microtherion/AutoISP/AutoISP.brd

## EAGLE design AutoISP.brd (2015-08-15)

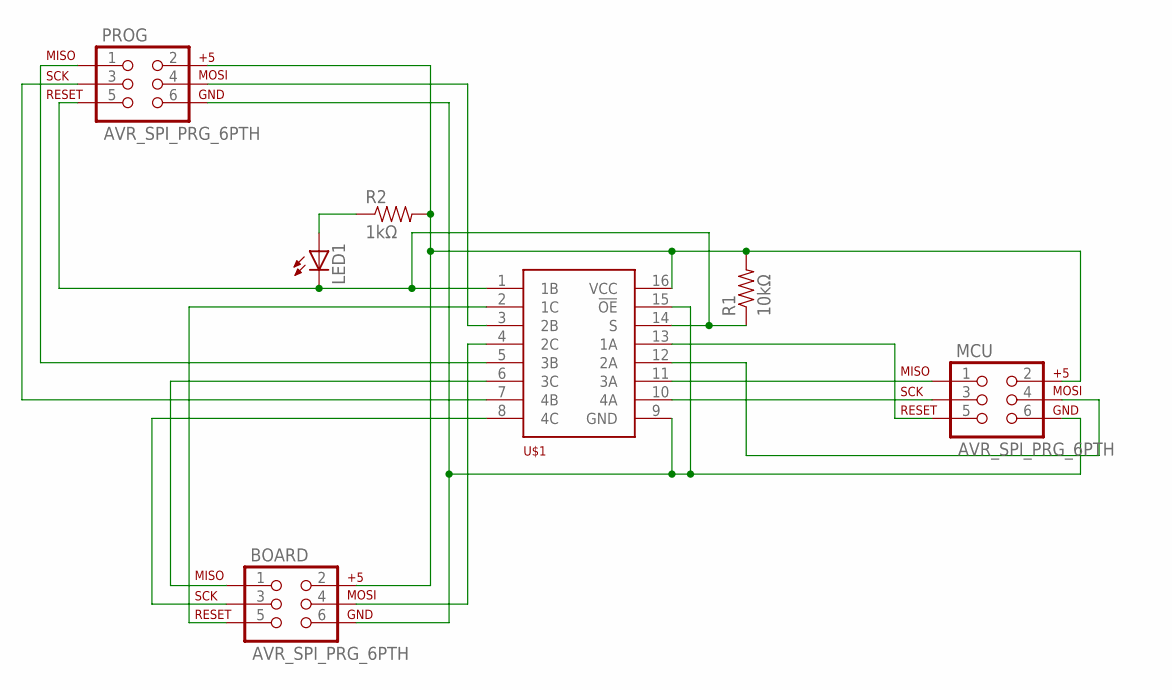
[picture p1: schematic AutoISP.sch]

Parts:
BOARD: AVR_SPI_PRG_6PTH; 2X3
LED1: LED1206; LED-1206
MCU: AVR_SPI_PRG_6PTH; 2X3
PROG: AVR_SPI_PRG_6PTH; 2X3
R1: 10kΩ; 0603-RES
R2: 1kΩ; 0603-RES
U$1: STMAV340TTR; TSSOP-16

Connections:
unnamed: LED1.C, PROG.5, R1.1, U$1.1 (1B), U$1.14 (S)
unnamed: PROG.4, U$1.3 (2B)
unnamed: PROG.1, U$1.5 (3B)
unnamed: PROG.3, U$1.7 (4B)
unnamed: BOARD.5, U$1.2 (1C)
unnamed: BOARD.6, MCU.6, PROG.6, U$1.9 (GND), U$1.15 (!OE)
unnamed: BOARD.2, MCU.2, PROG.2, R1.2, R2.2, U$1.16 (VCC)
unnamed: BOARD.4, U$1.4 (2C)
unnamed: BOARD.1, U$1.6 (3C)
unnamed: BOARD.3, U$1.8 (4C)
unnamed: MCU.5, U$1.13 (1A)
unnamed: MCU.4, U$1.12 (2A)
unnamed: MCU.1, U$1.11 (3A)
unnamed: MCU.3, U$1.10 (4A)
unnamed: LED1.A, R2.1

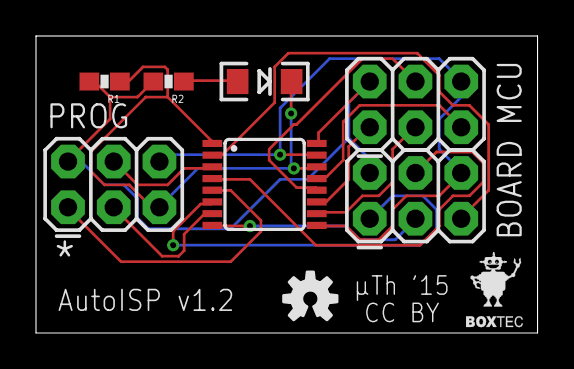
[picture p2: board AutoISP.brd from above]

Board: 2 copper layers, 27.9 x 16.5 mm, 9 parts (0 on the bottom side), 15 nets.

Other parts of the board:
U$2: ROBOXTEC-VECLOGO-NANO
U$3: OSHW-LOGO-S
