microtherion/AutoISP/AutoISP84.brd

## EAGLE design AutoISP84.brd (2015-08-15)

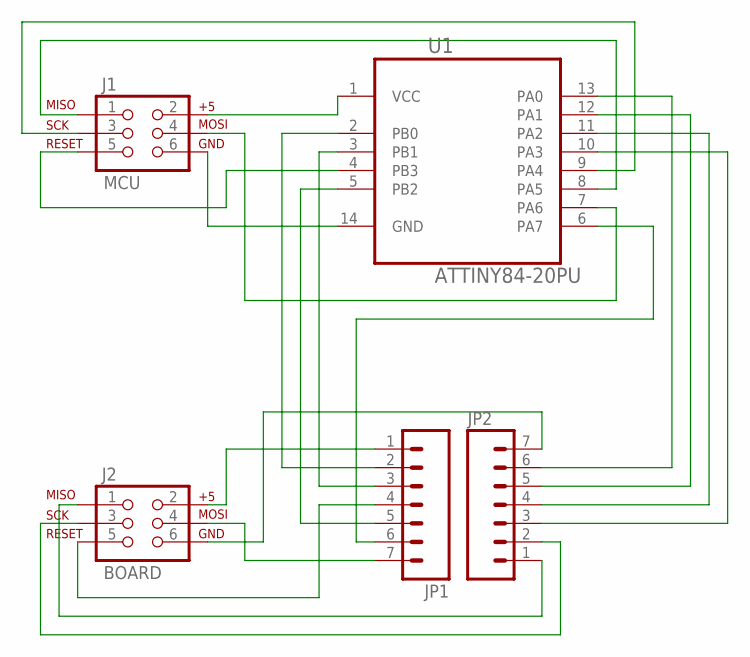
[picture p3: schematic AutoISP84.sch]

Parts:
J1: MCU; 2X3
J2: BOARD; 2X3
JP1, JP2: M07; 1X07
U1: ATTINY84-20PU; DIP254P762X533-14

Connections:
unnamed: J1.2, U1.1 (VCC)
unnamed: J2.2, JP1.1
unnamed: J2.6, JP2.7
unnamed: J1.6, U1.14 (GND)
unnamed: J1.5, U1.4 (PB3)
unnamed: J1.3, U1.9 (PA4)
unnamed: J2.5, JP1.4
unnamed: J1.4, U1.7 (PA6)
unnamed: J1.1, U1.8 (PA5)
unnamed: JP2.6, U1.13 (PA0)
unnamed: JP1.5, U1.5 (PB2)
unnamed: JP1.3, U1.3 (PB1)
unnamed: JP1.2, U1.2 (PB0)
unnamed: JP1.6, U1.6 (PA7)
unnamed: JP2.5, U1.12 (PA1)
unnamed: J2.4, JP1.7
unnamed: JP2.4, U1.11 (PA2)
unnamed: JP2.3, U1.10 (PA3)
unnamed: J2.1, JP2.1
unnamed: J2.3, JP2.2

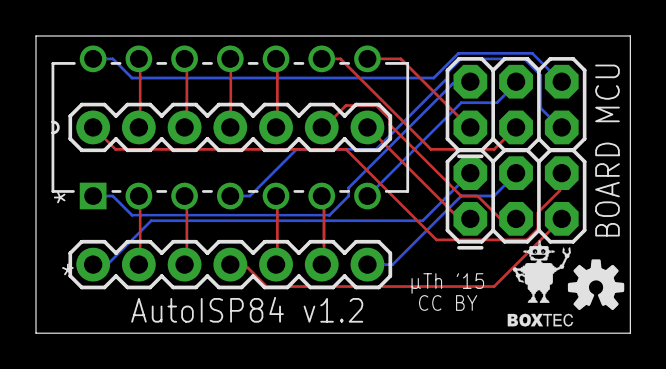
[picture p4: board AutoISP84.brd from above]

Board: 2 copper layers, 33.0 x 16.5 mm, 7 parts (0 on the bottom side), 20 nets.

Other parts of the board:
U$1: OSHW-LOGO-S
U$2: ROBOXTEC-VECLOGO-MICRO
