microtherion/AutoISP/AutoISP85.brd

## EAGLE design AutoISP85.brd (2015-08-15)

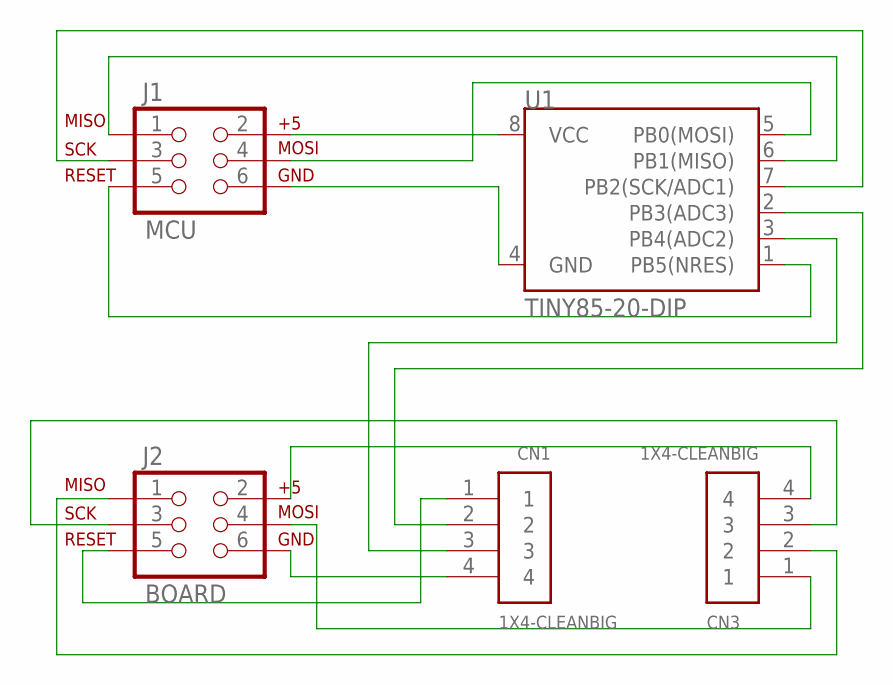
[picture p5: schematic AutoISP85.sch]

Parts:
CN1, CN3: 1X4-CLEANBIG; 1X04-CLEANBIG
J1: MCU; 2X3
J2: BOARD; 2X3
U1: TINY85-20-DIP; DIP08

Connections:
unnamed: J1.5, U1.1 (PB5(NRES))
unnamed: J1.2, U1.8 (VCC)
unnamed: J1.6, U1.4 (GND)
unnamed: J1.4, U1.5 (PB0(MOSI))
unnamed: CN1.1, J2.5
unnamed: CN1.2, U1.2 (PB3(ADC3))
unnamed: CN1.3, U1.3 (PB4(ADC2))
unnamed: CN1.4, J2.6
unnamed: CN3.1, J2.4
unnamed: CN3.2, J2.1
unnamed: CN3.3, J2.3
unnamed: CN3.4, J2.2
unnamed: J1.1, U1.6 (PB1(MISO))
unnamed: J1.3, U1.7 (PB2(SCK/ADC1))

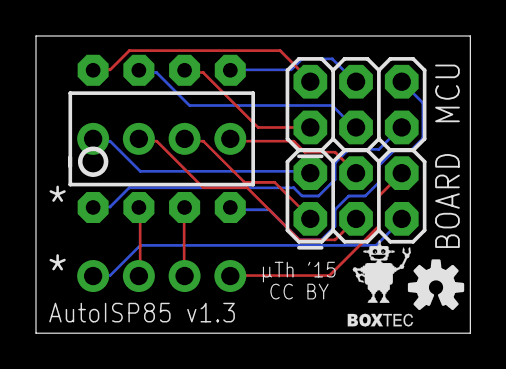
[picture p6: board AutoISP85.brd from above]

Board: 2 copper layers, 24.1 x 16.5 mm, 7 parts (1 on the bottom side), 14 nets.

Other parts of the board:
U$1: ROBOXTEC-VECLOGO-MICRO
U$2: OSHW-LOGO-S
