microtherion/AutoISP/AutoISP328.brd

## EAGLE design AutoISP328.brd (2015-08-15)

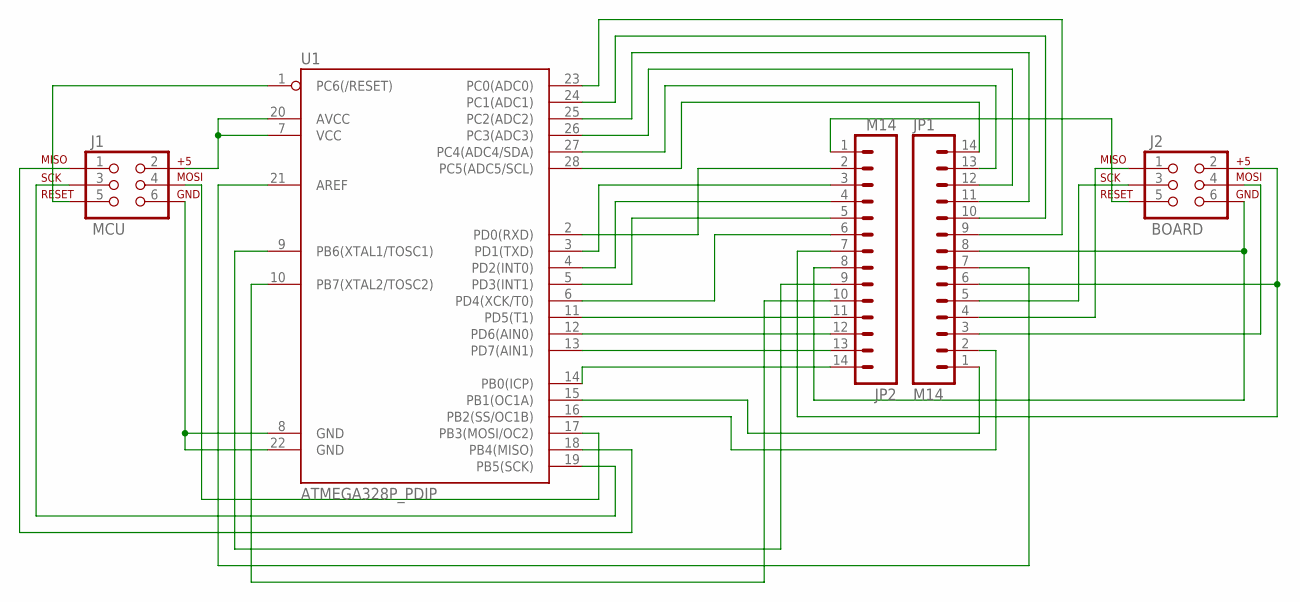
[picture p7: schematic AutoISP328.sch]

Parts:
J1: MCU; 2X3
J2: BOARD; 2X3
JP1, JP2: M14; 1X14
U1: ATMEGA328P_PDIP; DIL28-3

Connections:
unnamed: J1.5, U1.1 (PC6(/RESET))
unnamed: J1.2, U1.7 (VCC), U1.20 (AVCC)
unnamed: J1.6, U1.8 (GND), U1.22 (GND)
unnamed: J1.4, U1.17 (PB3(MOSI/OC2))
unnamed: J1.1, U1.18 (PB4(MISO))
unnamed: J1.3, U1.19 (PB5(SCK))
unnamed: J2.3, JP1.5
unnamed: J2.1, JP1.4
unnamed: J2.6, JP1.8, JP2.8
unnamed: JP1.14, U1.28 (PC5(ADC5/SCL))
unnamed: J2.4, JP1.3
unnamed: J2.2, JP1.6, JP2.7
unnamed: J2.5, JP2.1
unnamed: JP1.7, U1.21 (AREF)
unnamed: JP2.9, U1.9 (PB6(XTAL1/TOSC1))
unnamed: JP2.10, U1.10 (PB7(XTAL2/TOSC2))
unnamed: JP1.13, U1.27 (PC4(ADC4/SDA))
unnamed: JP1.12, U1.26 (PC3(ADC3))
unnamed: JP1.11, U1.25 (PC2(ADC2))
unnamed: JP1.10, U1.24 (PC1(ADC1))
unnamed: JP1.9, U1.23 (PC0(ADC0))
unnamed: JP2.2, U1.2 (PD0(RXD))
unnamed: JP2.3, U1.3 (PD1(TXD))
unnamed: JP2.4, U1.4 (PD2(INT0))
unnamed: JP2.5, U1.5 (PD3(INT1))
unnamed: JP2.6, U1.6 (PD4(XCK/T0))
unnamed: JP2.11, U1.11 (PD5(T1))
unnamed: JP2.12, U1.12 (PD6(AIN0))
unnamed: JP2.13, U1.13 (PD7(AIN1))
unnamed: JP2.14, U1.14 (PB0(ICP))
unnamed: JP1.1, U1.15 (PB1(OC1A))
unnamed: JP1.2, U1.16 (PB2(SS/OC1B))

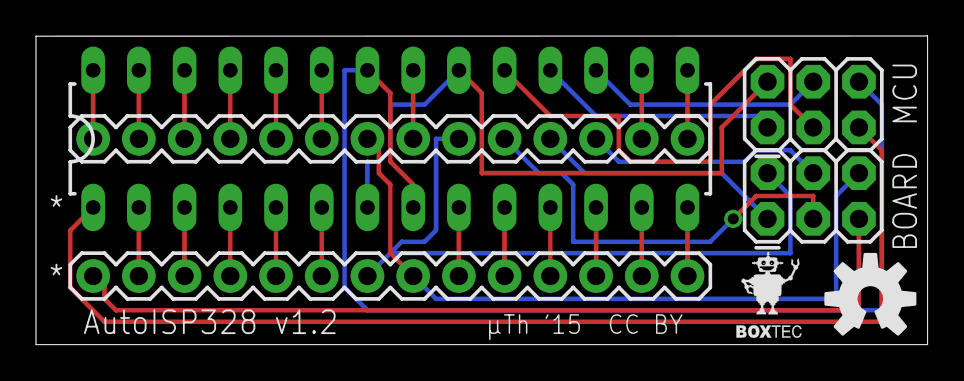
[picture p8: board AutoISP328.brd from above]

Board: 2 copper layers, 49.5 x 17.1 mm, 7 parts (0 on the bottom side), 32 nets.

Other parts of the board:
U$1: OSHW-LOGO-M
U$2: ROBOXTEC-VECLOGO-MICRO
