microtherion/AutoISP/(commit log)

2014-10-25 AutoISP{,85} 1.0 manufactured
    [AutoISP.brd, AutoISP.sch, AutoISP85.brd, AutoISP85.sch]
2014-11-10 AutoISP 1.1, fixing reversed pins
    [AutoISP.brd, AutoISP.sch]
2014-11-10 Added AutoISP84
    [AutoISP84.brd, AutoISP84.sch]
2015-03-21 Revise boards for better labelling and sane orientation, add AutoISP328
    [AutoISP.brd, AutoISP.sch, AutoISP328.brd, AutoISP328.sch, AutoISP84.brd, AutoISP84.sch, AutoISP85.brd, AutoISP85.sch]
2015-04-29 AutoISP85 1.3 (Fix flipped pin header) Add BOM
    [AutoISP.brd, AutoISP.sch, AutoISP328.brd, AutoISP84.brd, AutoISP84.sch, AutoISP85.brd]
2015-06-17 Add generated Gerbers
    [AutoISP.drills.xln, AutoISP328.drills.xln, AutoISP84.drills.xln, AutoISP85.drills.xln]
2015-08-15 Make polygon width nonzero
    [AutoISP.brd, AutoISP328.brd, AutoISP84.brd, AutoISP85.brd]
