microtherion/AutoISP/(notices)

Notices in the files:
AutoISP328.brd:
µTh '15 CC BY
AutoISP85.brd:
CC BY
parts and their libraries:
SparkFun-Connectors: Licensing: CC v3.0 Share-Alike You are welcome to use this library for commercial purposes.
